hapcan/UNIV_3.2.2.x/Readme.md

UNIV 3.2.2.x
============

RELAY MODULE - 6 bistable 5A relays

Device webpage: http://hapcan.com/devices/universal/univ_3/univ_3-2-2-x/

Hardware created in Eagle PCB Software http://www.cadsoftusa.com/

Firmware created in Microchip MPLAB http://www.microchip.com/mplabide/ in assembly language
