hapcan/UNIV_3.2.2.x/Hardware_UNIV_3.2.2.x/univ_3-2-2-x-label.docx

BISTABLE RELAY

6 CHANNEL

IN = 5A

UN = 250V AC
TYPE | UNIV 3.2.2.x
S/N | 00000602h
BUS BUS | hapcan.com

PRZEKAŹNIK BISTABILNY

6 KANAŁOWY

IN = 5A

UN = 250V AC
TYP | UNIV 3.2.2.x
S/N | 00000602h
BUS BUS | hapcan.com
