hapcan/UNIV_3.2.2.x/Hardware_UNIV_3.2.2.x/rev2/pcb_univ_3-2-(1-2)-x-rev2.brd

## EAGLE design Hardware_UNIV_3.2.2.x/rev2/pcb_univ_3-2-(1-2)-x-rev2.brd (2016-11-11)

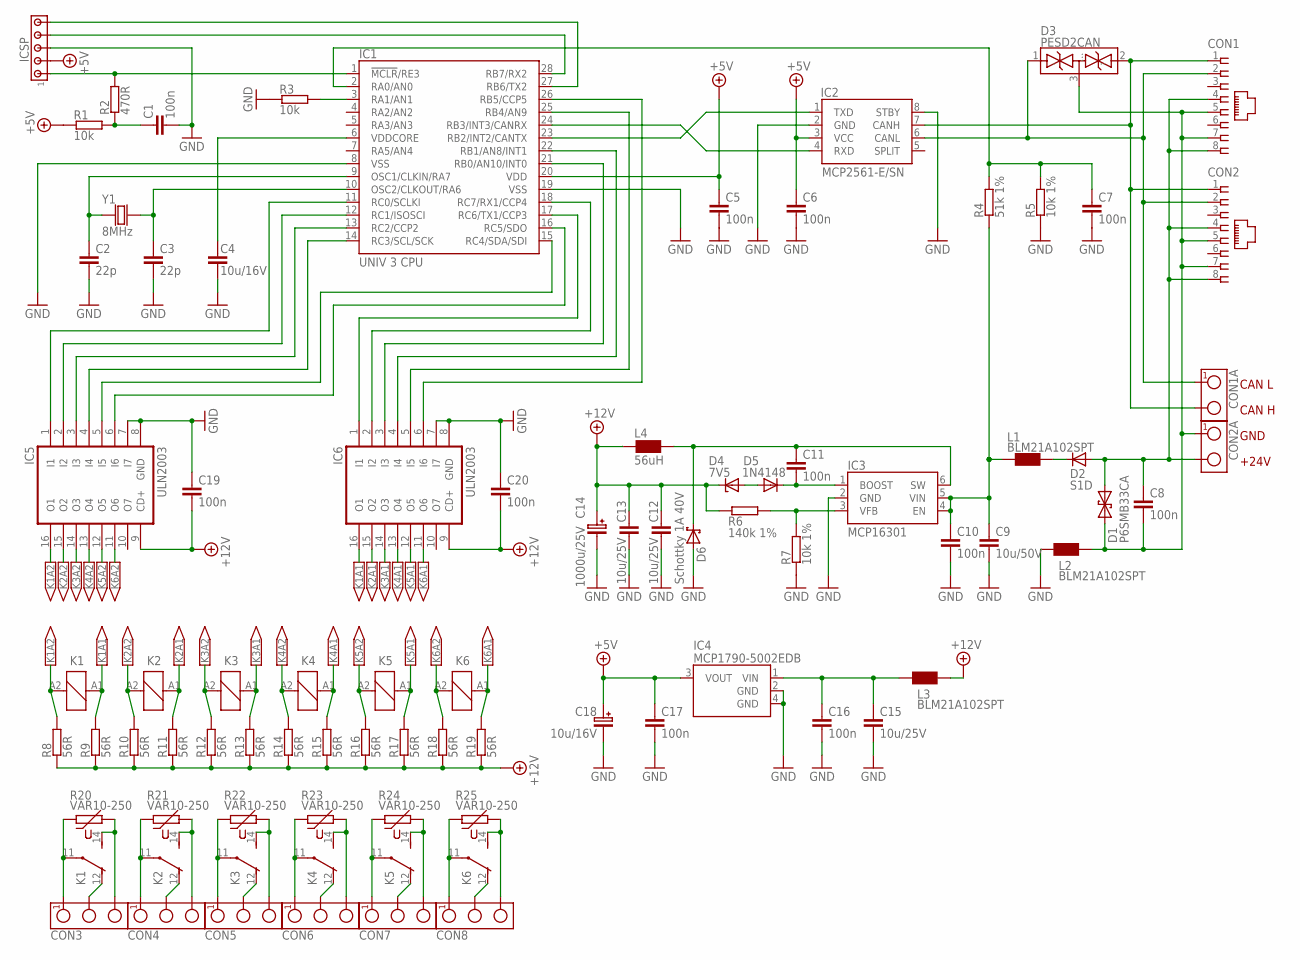
[picture p9: schematic pcb_univ_3-2-(1-2)-x-rev2.sch]

Parts:
C1, C5, C6, C7, C8, C10, C11, C16, C17, C19, C20: 100n; 0805
C2, C3: 22p; 0805
C4: 10u/16V; 0805
C9: 10u/50V; 1210
C12, C13, C15: 10u/25V; 1206
C14: 1000u/25V; CAP-5X10.5
C18: 10u/16V; SMC_B
CON1, CON2: RJ45-SOCKET; RJ45-PCB-SOCKET
CON1A, CON2A: TERMINAL-2; ARK2-5X10,5MM
CON3, CON4, CON5, CON6, CON7, CON8: TERMINAL-3-5X10.5MM; ARK3-5X10.5MM
D1: P6SMB33CA; DO-214_TRANSIL2
D2: S1D; DO-214
D3: PESD2CAN; SOT-23
D4: 7V5; SOD-80
D5: 1N4148; 0805
D6: Schottky 1A 40V; DO-214
IC1: UNIV 3 CPU; UNIV3CPU
IC2: MCP2561-E/SN; SO-08
IC3: MCP16301; SOT-23-6
IC4: MCP1790-5002EDB; SOT-223
IC5, IC6: ULN2003; SO-16
ICSP: HEADER5; SIP-5
K1, K2, K3, K4, K5, K6: RELAY_PE
L1, L2, L3: BLM21A102SPT; 0805
L4: 56uH; CHOKE-DER0705
R1, R3: 10k; 0805
R2: 470R; 0805
R4: 51k 1%; 0805
R5, R7: 10k 1%; 0805
R6: 140k 1%; 0805
R8, R9, R10, R11, R12, R13, R14, R15, R16, R17, R18, R19: 56R; 1206
R20, R21, R22, R23, R24, R25: VAR10-250; VARISTOR1
Y1: 8MHz; CRYSTAL-HC49V

Connections:
+5V: C5.1, C6.1, C17.1, C18.+ (1), IC1.20 (VDD), IC2.3 (VCC), IC4.3 (VOUT), ICSP.2, R1.1
+12V: C12.1, C13.1, C14.+ (1), C19.2, C20.2, D4.C, IC5.9 (CD+), IC6.9 (CD+), L3.2, L4.1, R6.1, R8.1, R9.1, R10.1, R11.1, R12.1, R13.1, R14.1, R15.1, R16.1, R17.1, R18.1, R19.1
GND: C1.2, C2.2, C3.2, C4.2, C5.2, C6.2, C7.2, C9.2, C10.2, C12.2, C13.2, C14.- (2), C15.2, C16.2, C17.2, C18.- (2), C19.1, C20.1, D6.A, IC1.8 (VSS), IC1.19 (VSS), IC2.2 (GND), IC2.8 (STBY), IC3.2 (GND), IC4.2 (GND), IC4.4 (GND), IC5.7 (I7), IC5.8 (GND), IC6.7 (I7), IC6.8 (GND), ICSP.3, L2.1, R3.1, R5.1, R7.1
K1A1: IC6.16 (O1), K1.A1 (1), R9.2
K1A2: IC5.16 (O1), K1.A2 (2), R8.2
K2A1: IC6.15 (O2), K2.A1 (1), R11.2
K2A2: IC5.15 (O2), K2.A2 (2), R10.2
K3A1: IC6.14 (O3), K3.A1 (1), R13.2
K3A2: IC5.14 (O3), K3.A2 (2), R12.2
K4A1: IC6.13 (O4), K4.A1 (1), R15.2
K4A2: IC5.13 (O4), K4.A2 (2), R14.2
K5A1: IC6.12 (O5), K5.A1 (1), R17.2
K5A2: IC5.12 (O5), K5.A2 (2), R16.2
K6A1: IC6.11 (O6), K6.A1 (1), R19.2
K6A2: IC5.11 (O6), K6.A2 (2), R18.2
unnamed: D2.C, L1.2
unnamed: IC1.24 (RB3/INT3/CANRX), IC2.4 (RXD)
unnamed: IC1.23 (RB2/INT2/CANTX), IC2.1 (TXD)
unnamed: CON1.1, CON1A.2, CON2.1, D3.2 (..), IC2.7 (CANH)
unnamed: C9.1, C10.1, IC3.4 (EN), IC3.5 (VIN), L1.1, R4.1
unnamed: C15.1, C16.1, IC4.1 (VIN), L3.1
unnamed: C1.1, R1.2, R2.1
unnamed: IC1.1 (!MCLR!/RE3), ICSP.1, R2.2
unnamed: C8.1, CON1.4, CON1.8, CON2.4, CON2.8, CON2A.2, D1.C (2), D2.A
unnamed: IC1.28 (RB7/RX2), ICSP.4
unnamed: IC1.12 (RC1/ISOSCI), IC5.2 (I2)
unnamed: IC1.3 (RA1/AN1), R3.2
unnamed: C8.2, CON1.5, CON1.7, CON2.5, CON2.7, CON2A.1, D1.A (1), D3.3 (...), L2.2
unnamed: IC1.27 (RB6/TX2), ICSP.5
unnamed: C3.1, IC1.10 (OSC2/CLKOUT/RA6), Y1.2
unnamed: C7.1, IC1.2 (RA0/AN0), R4.2, R5.2
unnamed: C11.1, D6.C, IC3.6 (SW), L4.2
unnamed: IC1.11 (RC0/SCLKI), IC5.1 (I1)
unnamed: IC1.13 (RC2/CCP2), IC5.3 (I3)
unnamed: IC3.3 (VFB), R6.2, R7.2
unnamed: CON3.2, K1.12 (NC)
unnamed: IC1.14 (RC3/SCL/SCK), IC5.4 (I4)
unnamed: D4.A, D5.2 (A)
unnamed: IC1.15 (RC4/SDA/SDI), IC5.5 (I5)
unnamed: CON4.2, K2.12 (NC)
unnamed: CON5.2, K3.12 (NC)
unnamed: CON1.2, CON1A.1, CON2.2, D3.1 (.), IC2.6 (CANL)
unnamed: CON6.2, K4.12 (NC)
unnamed: CON7.2, K5.12 (NC)
unnamed: CON3.1, K1.11 (COM), R20.1
unnamed: CON8.2, K6.12 (NC)
unnamed: CON3.3, K1.14 (NO), R20.2
unnamed: C11.2, D5.1 (C), IC3.1 (BOOST)
unnamed: C2.1, IC1.9 (OSC1/CLKIN/RA7), Y1.1
unnamed: IC1.16 (RC5/SDO), IC5.6 (I6)
unnamed: IC1.17 (RC6/TX1/CCP3), IC6.1 (I1)
unnamed: IC1.18 (RC7/RX1/CCP4), IC6.2 (I2)
unnamed: CON4.3, K2.14 (NO), R21.2
unnamed: CON5.3, K3.14 (NO), R22.2
unnamed: CON6.3, K4.14 (NO), R23.2
unnamed: CON7.3, K5.14 (NO), R24.2
unnamed: CON8.3, K6.14 (NO), R25.2
unnamed: C4.1, IC1.6 (VDDCORE)
unnamed: CON4.1, K2.11 (COM), R21.1
unnamed: CON5.1, K3.11 (COM), R22.1
unnamed: CON6.1, K4.11 (COM), R23.1
unnamed: CON7.1, K5.11 (COM), R24.1
unnamed: CON8.1, K6.11 (COM), R25.1
unnamed: IC1.21 (RB0/AN10/INT0), IC6.3 (I3)
unnamed: IC1.22 (RB1/AN8/INT1), IC6.4 (I4)
unnamed: IC1.25 (RB4/AN9), IC6.5 (I5)
unnamed: IC1.26 (RB5/CCP5), IC6.6 (I6)

Notes on the sheet:
CAN L
CAN H
GND
+24V

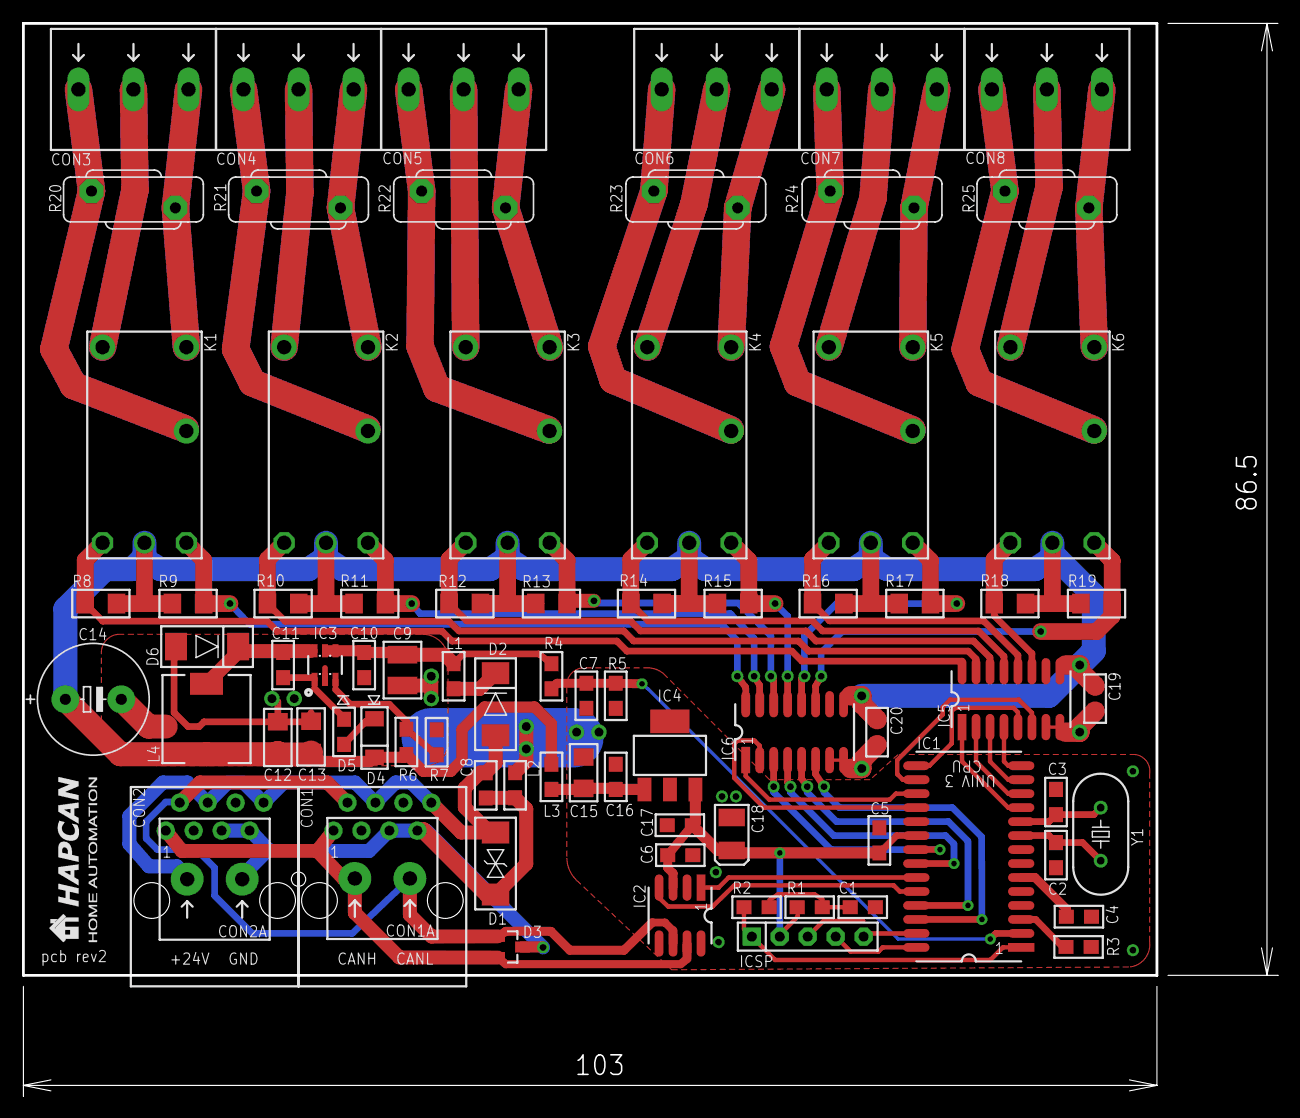
[picture p10: board pcb_univ_3-2-(1-2)-x-rev2.brd from above]

Board: 2 copper layers, 103.0 x 86.5 mm, 79 parts (0 on the bottom side), 67 nets.
