hapcan/UNIV_3.2.2.x/(commit log)

2014-06-20 firmware UNIV 3.2.2.0 revision 0
    [univ_3-2-2-0-rev0-memory.xlsx]
2014-06-20 Revert "firmware UNIV 3.2.2.0 revision 0"
    This reverts commit 68ff484def2ee67796a1b25d94935ce2db520174.
    [univ_3-2-2-0-rev0-memory.xlsx]
2014-06-20 hardware UNIV 3.2.2.x revision 1
    [pcb_univ_3-2-(1-2)-x-rev1.brd, pcb_univ_3-2-(1-2)-x-rev1.sch, univ_3-2-2-x-rev1.sch]
2016-10-30 firmware UNIV 3.2.2.0 revision 1
    [univ_3-2-2-0-rev1-memory.xlsx]
2016-11-11 hardware UNIV 3.2.2.x revision 2
    [pcb_univ_3-2-(1-2)-x-rev2.brd, pcb_univ_3-2-(1-2)-x-rev2.sch, univ_3-2-2-x-rev2.sch]
2022-10-31 firmware UNIV 3.2.2.0 revision 2
    [univ_3-2-2-0-rev2-memory.xlsx]
